devenaj21/Wax-Ball-Making-Machine/README.md

# Wax-Ball-Making-Machine
Project Report and design of TA202 Project 'Wax Ball Making Machine'
