devenaj21/Wax-Ball-Making-Machine/(list of files, cad)

Other CAD files:
Inventor Parts and Assembly/Angle.ipt
Inventor Parts and Assembly/Assembly.iam
Inventor Parts and Assembly/Base Plate.ipt
Inventor Parts and Assembly/Box.ipt
Inventor Parts and Assembly/CounterWeight.ipt
Inventor Parts and Assembly/Frame.ipt
Inventor Parts and Assembly/Gears.iam
Inventor Parts and Assembly/SpurFixed.iam
Inventor Parts and Assembly/SpurLarge.iam
Inventor Parts and Assembly/SpurSmall.iam
Inventor Parts and Assembly/Stand.ipt
Inventor Parts and Assembly/collar.ipt
