devenaj21/Wax-Ball-Making-Machine/Drawings and Report/Base Plate.pdf

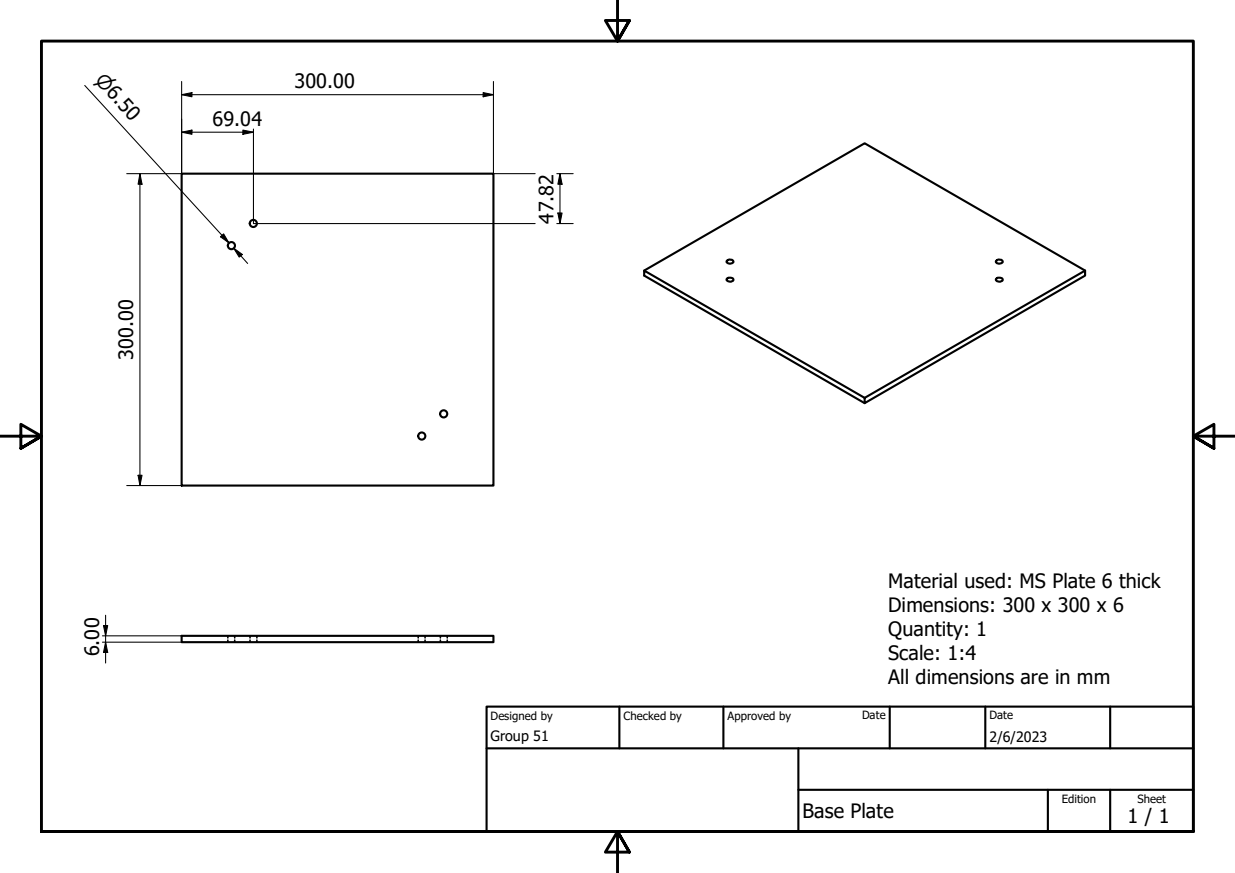
[picture p3: page 1]
Base Plate; Group 51; Designed by; Checked by; Approved by; Date

Material used: MS Plate 6 thick
Dimensions: 300 x 300 x 6
Quantity: 1
Scale: 1:4
All dimensions are in mm
