devenaj21/Wax-Ball-Making-Machine/Drawings and Report/BevelGear.pdf

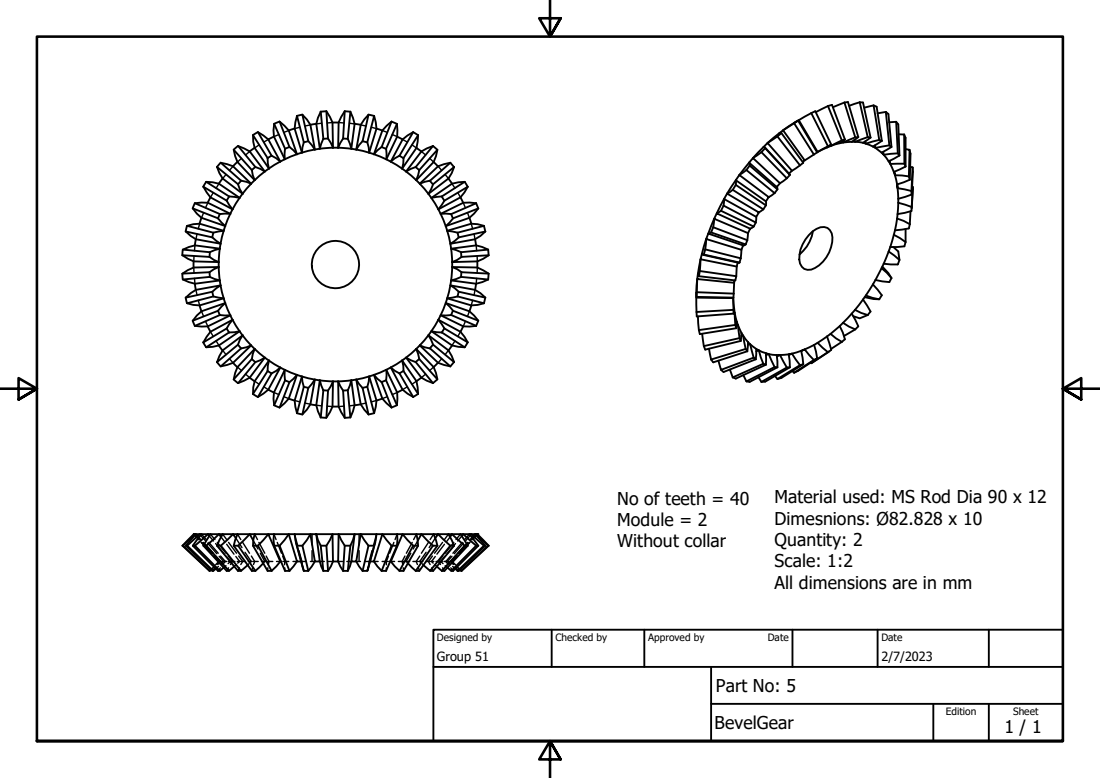
[picture p4: page 1]

No of teeth = 40
Module = 2
Without collar

Material used: MS Rod Dia 90 x 12
Dimesnions: Ø82.828 x 10
Quantity: 2
Scale: 1:2
All dimensions are in mm

Designed by Group 51 | Checked by | Approved by Date | Date 2/7/2023

Part No: 5
BevelGear | Edition | Sheet 1 / 1
