devenaj21/Wax-Ball-Making-Machine/Drawings and Report/Box.pdf

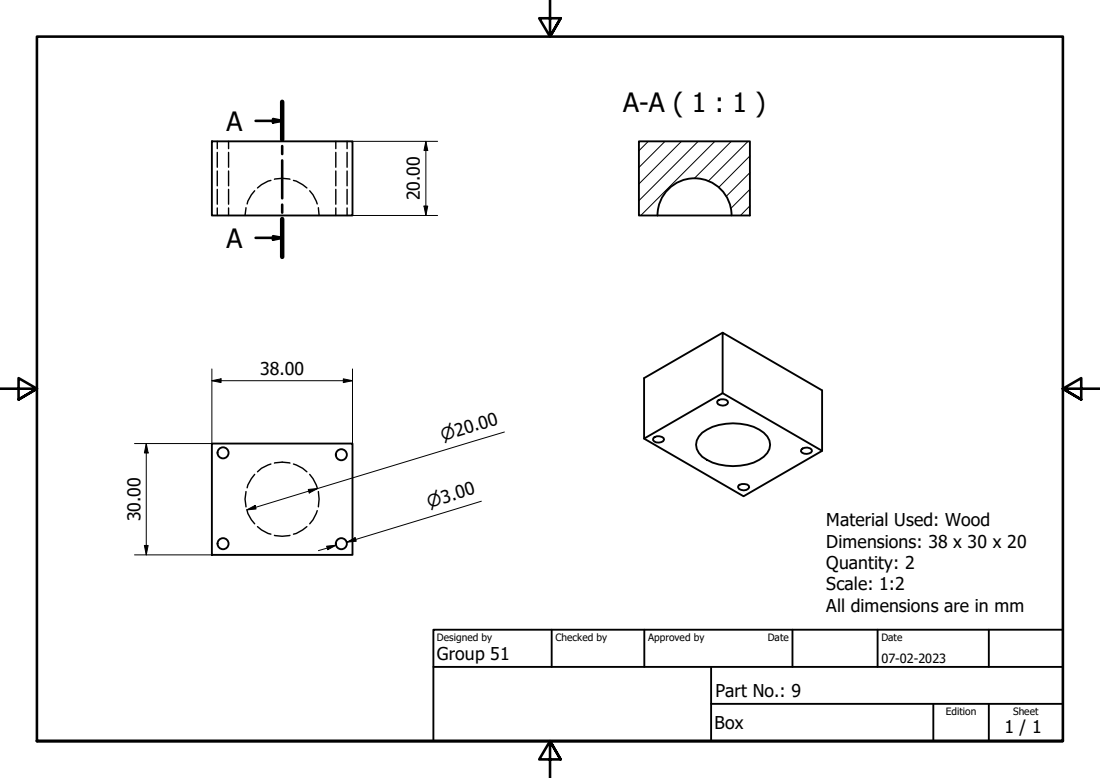
[picture p5: page 1]

Material Used: Wood
Dimensions: 38 x 30 x 20
Quantity: 2
Scale: 1:2
All dimensions are in mm

Designed by Group 51 | Checked by | Approved by Date | Date 07-02-2023

Part No.: 9
Box | Edition | Sheet 1 / 1
