devenaj21/Wax-Ball-Making-Machine/Drawings and Report/Frame(a).pdf

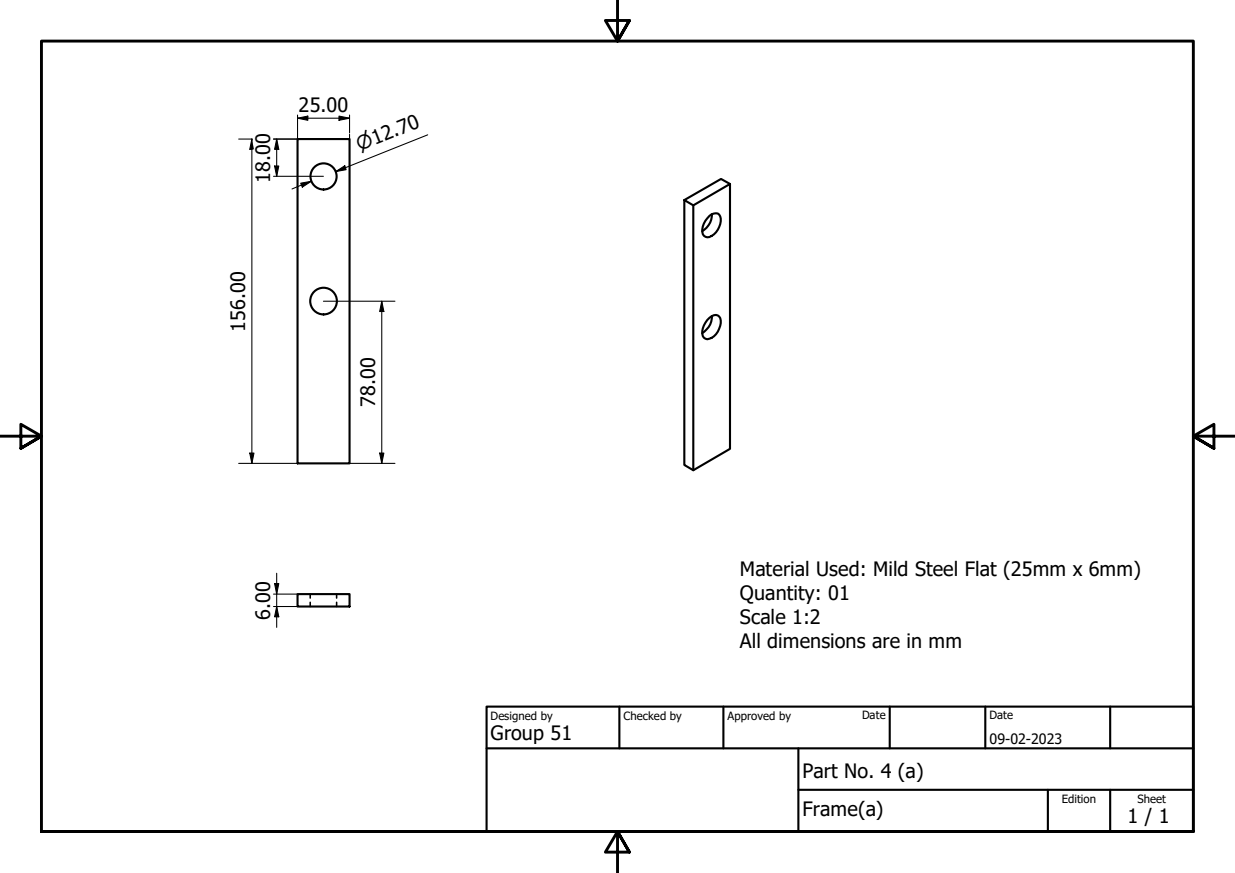
[picture p6: page 1]

Material Used: Mild Steel Flat (25mm x 6mm)
Quantity: 01
Scale 1:2
All dimensions are in mm

Designed by Group 51 | Checked by | Approved by Date | Date 09-02-2023

Part No. 4 (a)
Frame(a) | Edition | Sheet 1 / 1
