devenaj21/Wax-Ball-Making-Machine/Drawings and Report/Frame(f).pdf

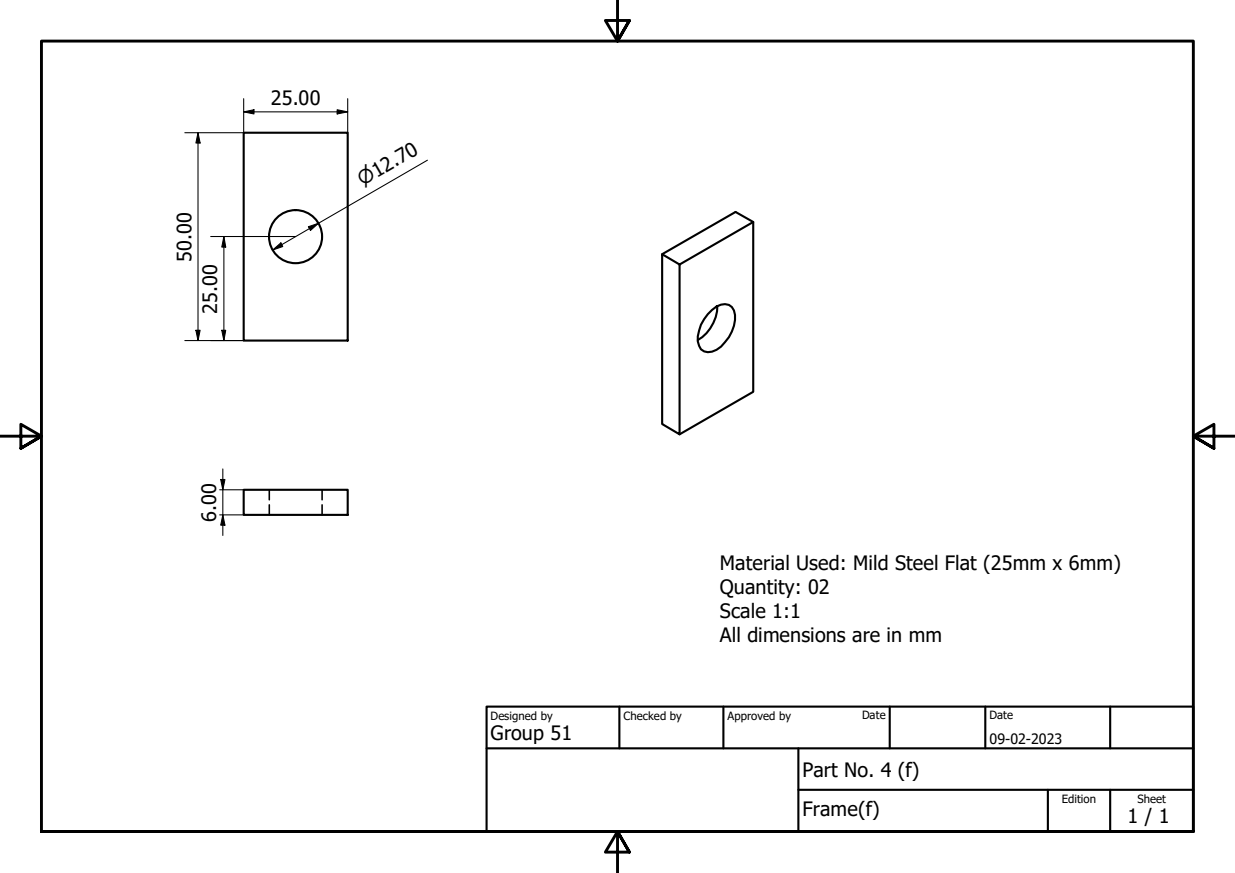
[picture p8: page 1]

Material Used: Mild Steel Flat (25mm x 6mm)
Quantity: 02
Scale 1:1
All dimensions are in mm

Designed by Group 51 | Checked by | Approved by Date | Date 09-02-2023

Part No. 4 (f)
Frame(f) | Edition | Sheet 1 / 1
