devenaj21/Wax-Ball-Making-Machine/Drawings and Report/Pin1.pdf

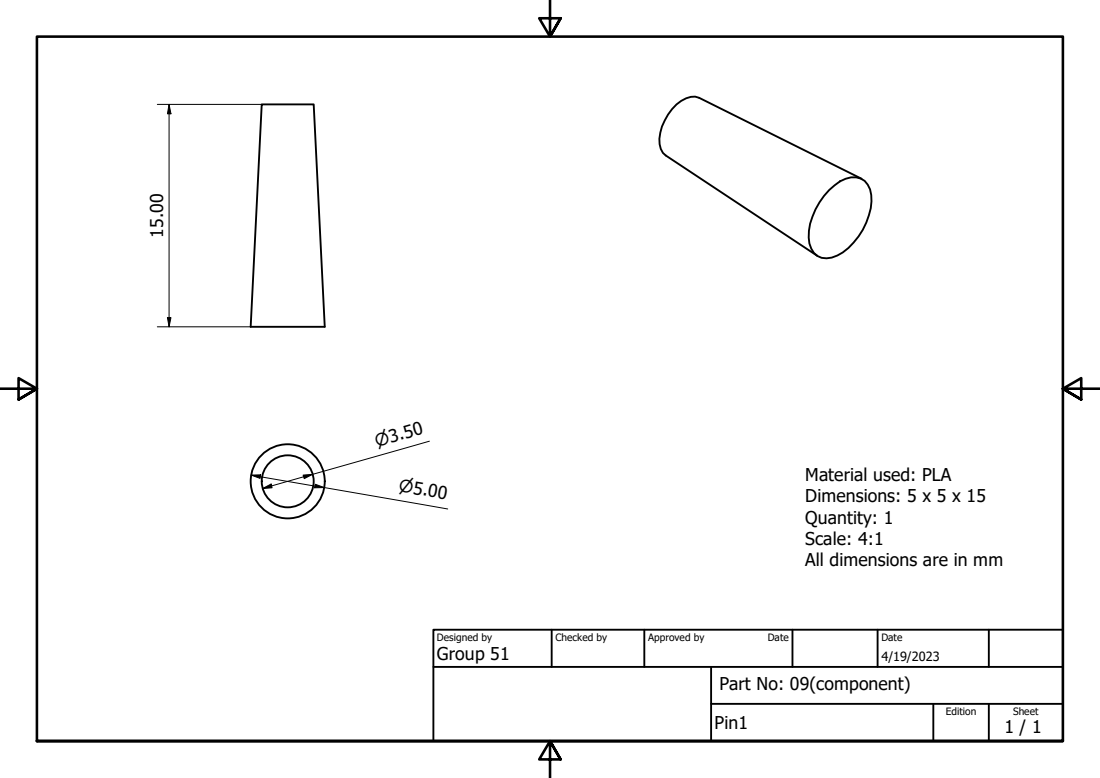
[picture p9: page 1]

Material used: PLA
Dimensions: 5 x 5 x 15
Quantity: 1
Scale: 4:1
All dimensions are in mm

Designed by Group 51 | Checked by | Approved by Date | Date 4/19/2023

Part No: 09(component)
Pin1 | Edition | Sheet 1 / 1
