devenaj21/Wax-Ball-Making-Machine/Drawings and Report/SpurFixed.pdf

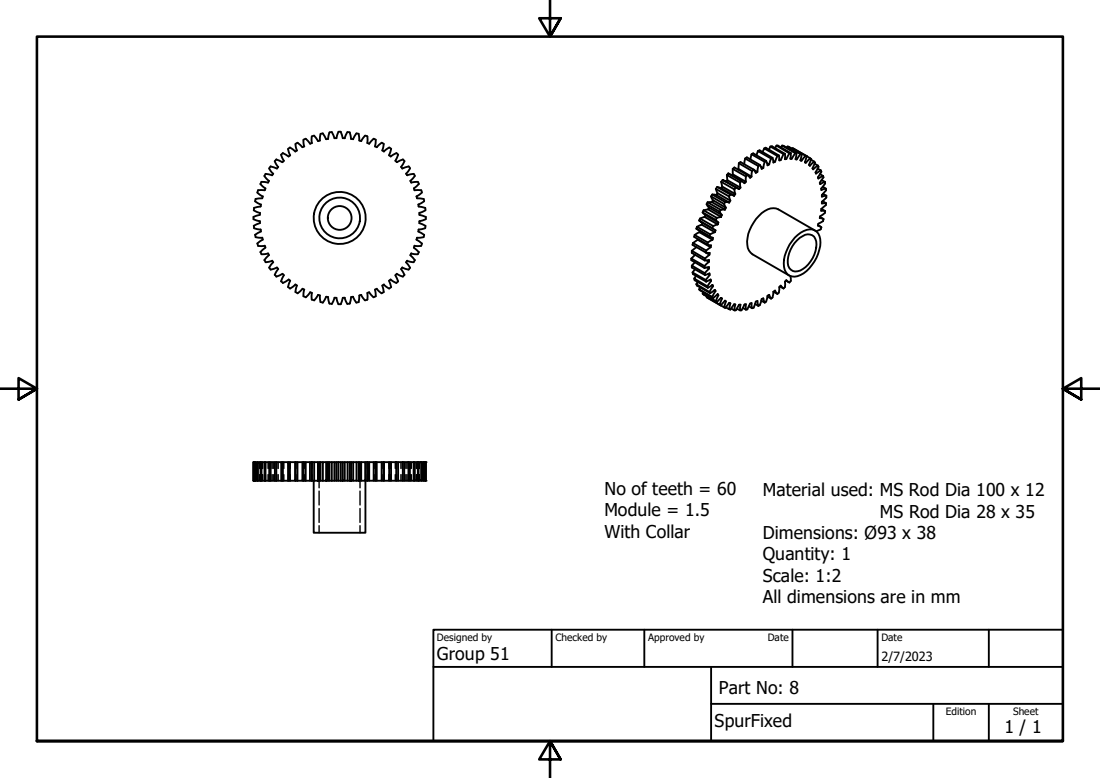
[picture p11: page 1]

No of teeth = 60
Module = 1.5
With Collar

Material used: MS Rod Dia 100 x 12

MS Rod Dia 28 x 35

Dimensions: Ø93 x 38
Quantity: 1
Scale: 1:2
All dimensions are in mm

Designed by Group 51 | Checked by | Approved by Date | Date 2/7/2023

Part No: 8
SpurFixed | Edition | Sheet 1 / 1
