devenaj21/Wax-Ball-Making-Machine/Drawings and Report/SpurLarge.pdf

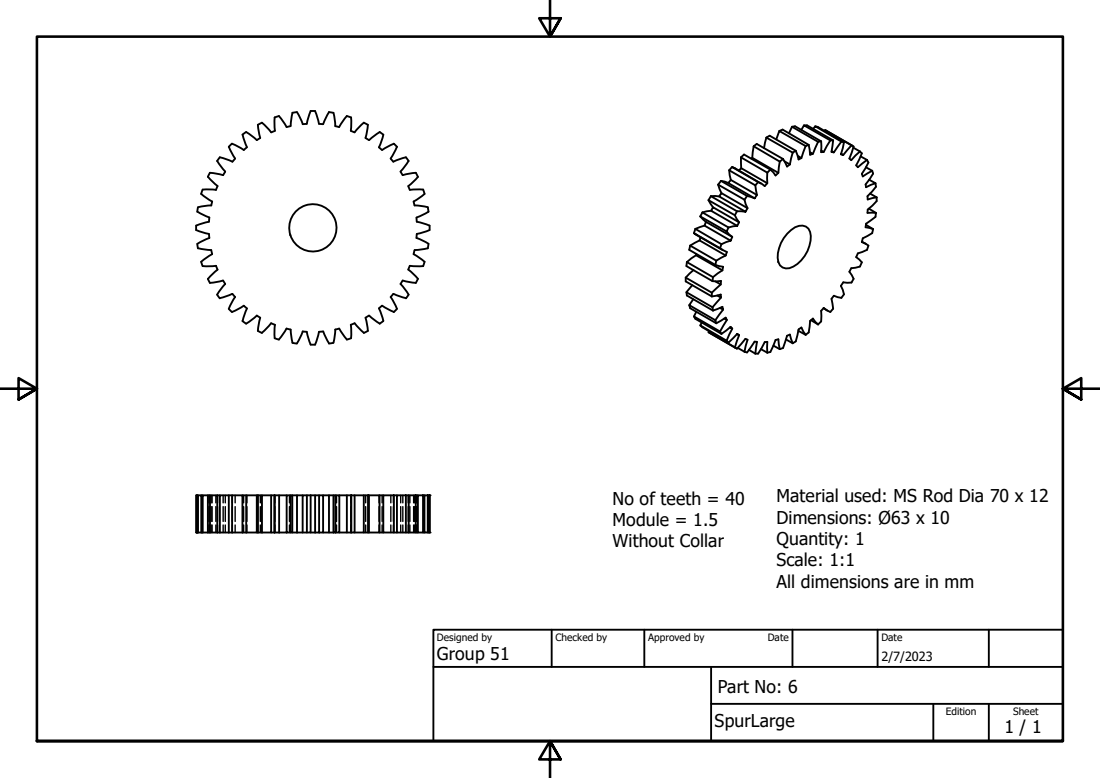
[picture p12: page 1]

No of teeth = 40
Module = 1.5
Without Collar

Material used: MS Rod Dia 70 x 12
Dimensions: Ø63 x 10
Quantity: 1
Scale: 1:1
All dimensions are in mm

Designed by Group 51 | Checked by | Approved by Date | Date 2/7/2023

Part No: 6
SpurLarge | Edition | Sheet 1 / 1
