devenaj21/Wax-Ball-Making-Machine/Drawings and Report/SpurSmall.pdf

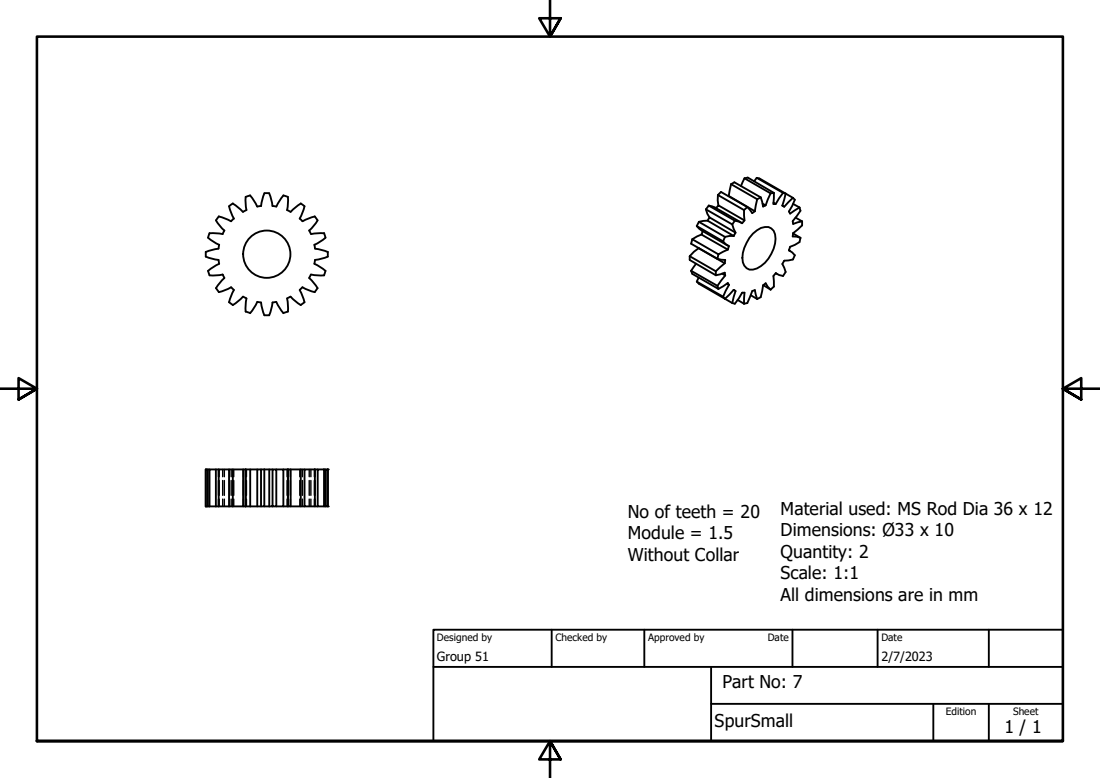
[picture p13: page 1]

No of teeth = 20
Module = 1.5
Without Collar

Material used: MS Rod Dia 36 x 12
Dimensions: Ø33 x 10
Quantity: 2
Scale: 1:1
All dimensions are in mm

Designed by Group 51 | Checked by | Approved by Date | Date 2/7/2023

Part No: 7

SpurSmall | Edition | Sheet 1 / 1
