devenaj21/Wax-Ball-Making-Machine/Drawings and Report/Stand.pdf

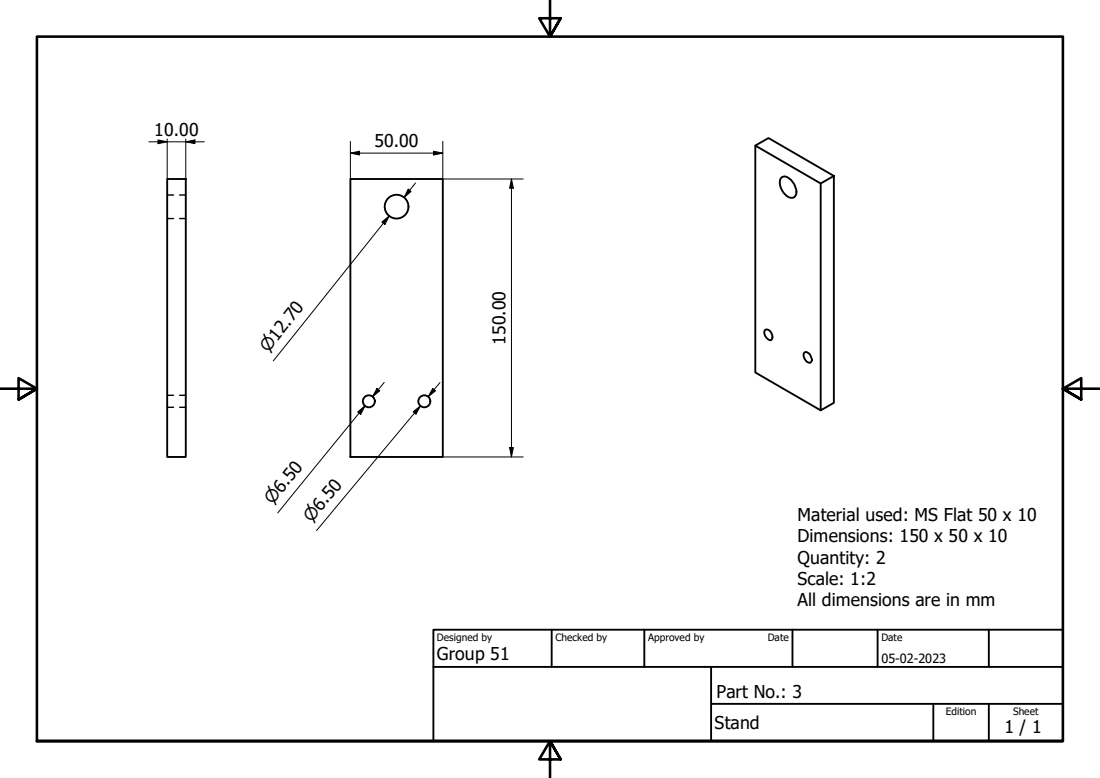
[picture p14: page 1]

Material used: MS Flat 50 x 10
Dimensions: 150 x 50 x 10
Quantity: 2
Scale: 1:2
All dimensions are in mm

Designed by Group 51 | Checked by | Approved by Date | Date 05-02-2023

Part No.: 3
Stand | Edition | Sheet 1 / 1
