devenaj21/Wax-Ball-Making-Machine/Drawings and Report/Angle.pdf

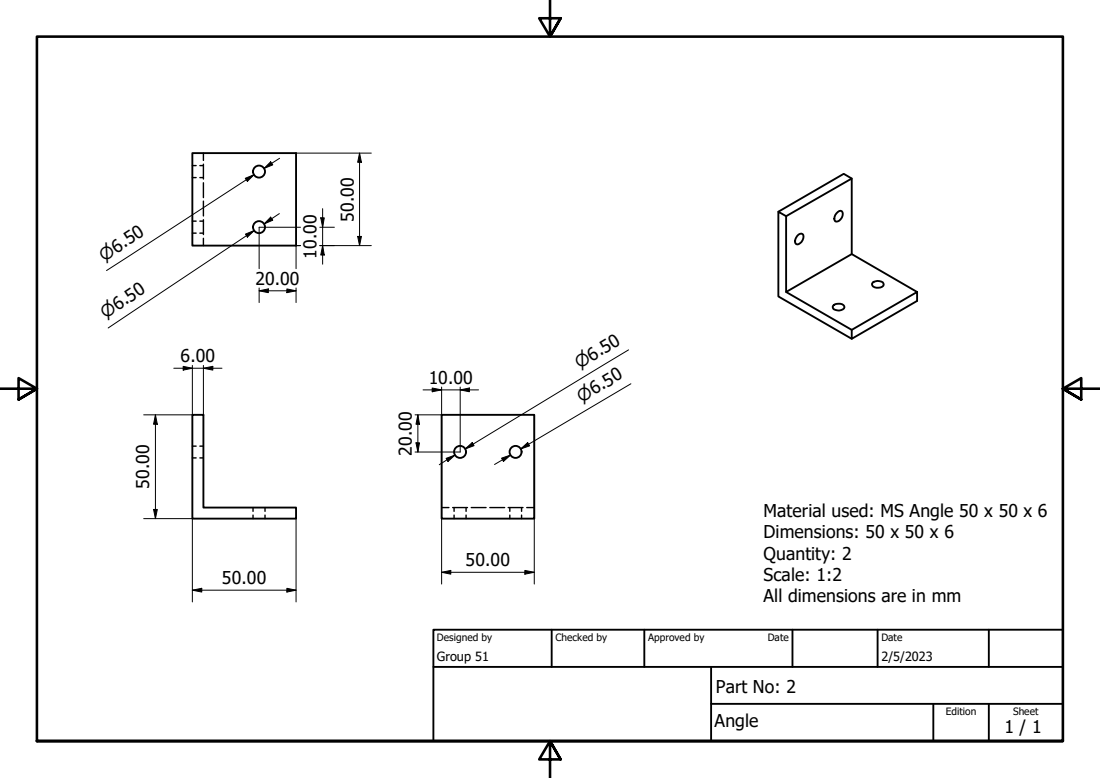
[picture p15: page 1]
All d

P a r t N o : 2
A n gle | E d i t i o n | S h e e t 1 / 1
