devenaj21/Wax-Ball-Making-Machine/Drawings and Report/Isometric.pdf

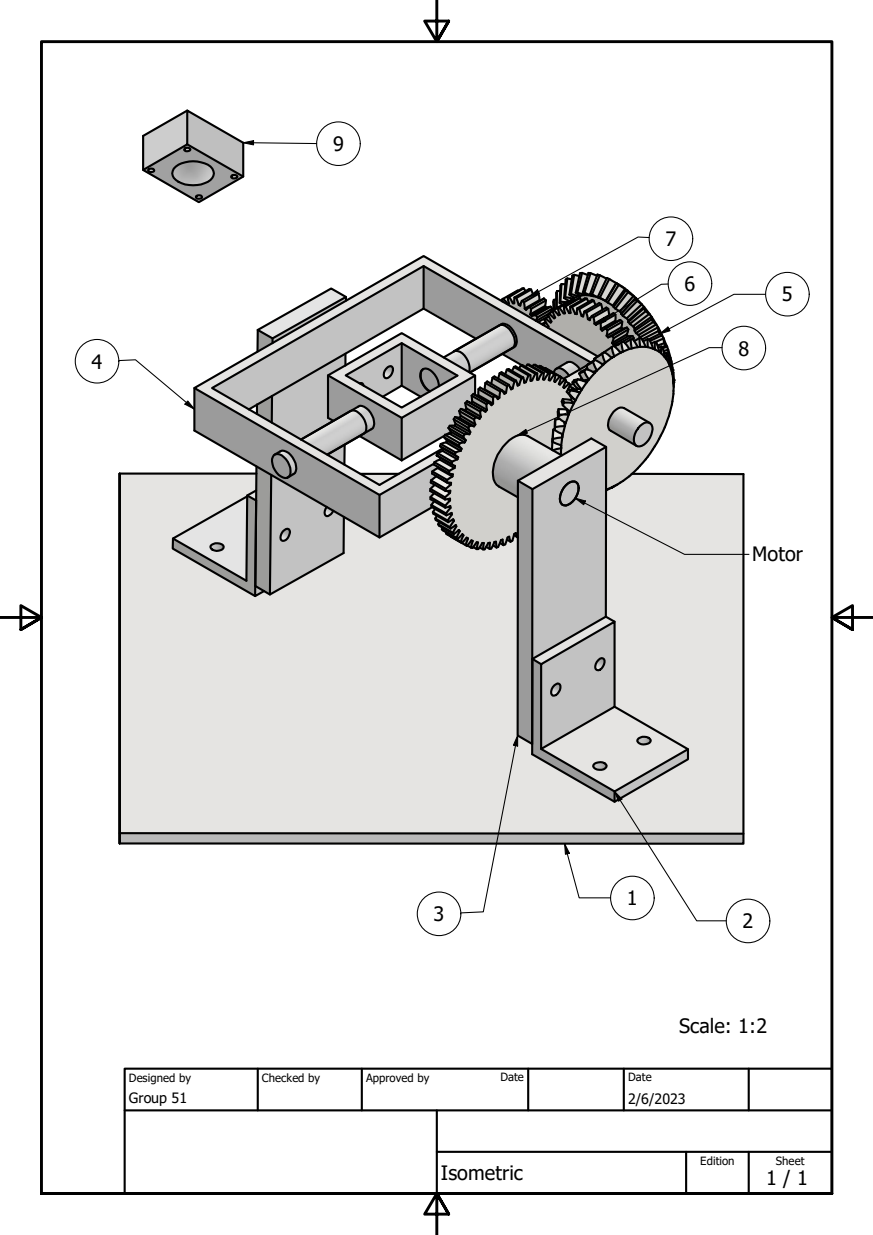
[picture p16: page 1]
Group 51; Designed by; Checked by; Approved by; Date; Scale: 1:2
